spawnID0001/allpeople-wave-pcb/resources/placement-idea-pcb.png

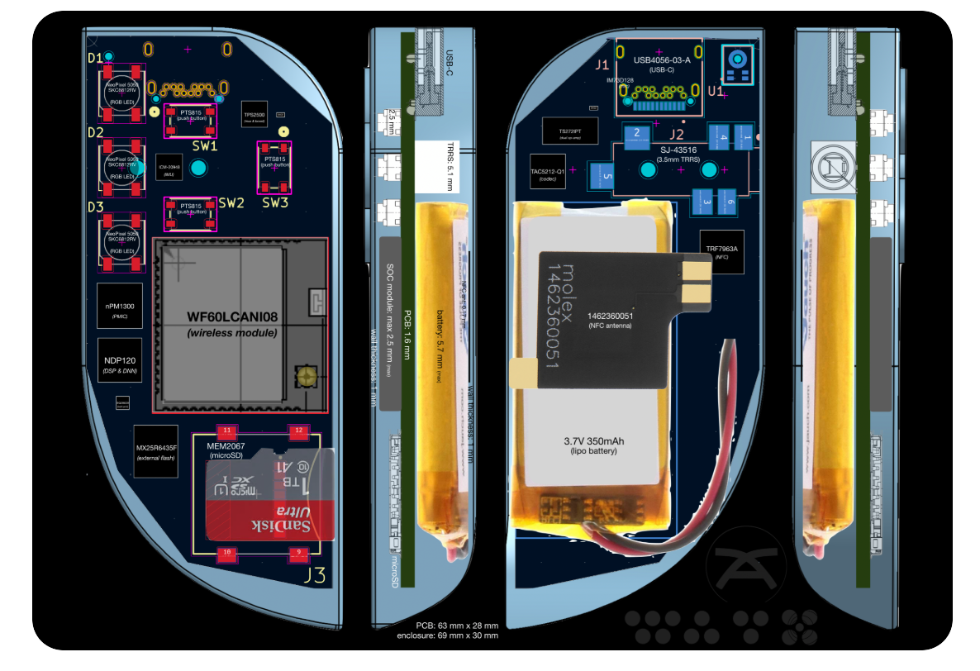
resources/placement-idea-pcb.png
