spawnID0001/allpeople-wave-pcb/resources/hardware-architecture.png

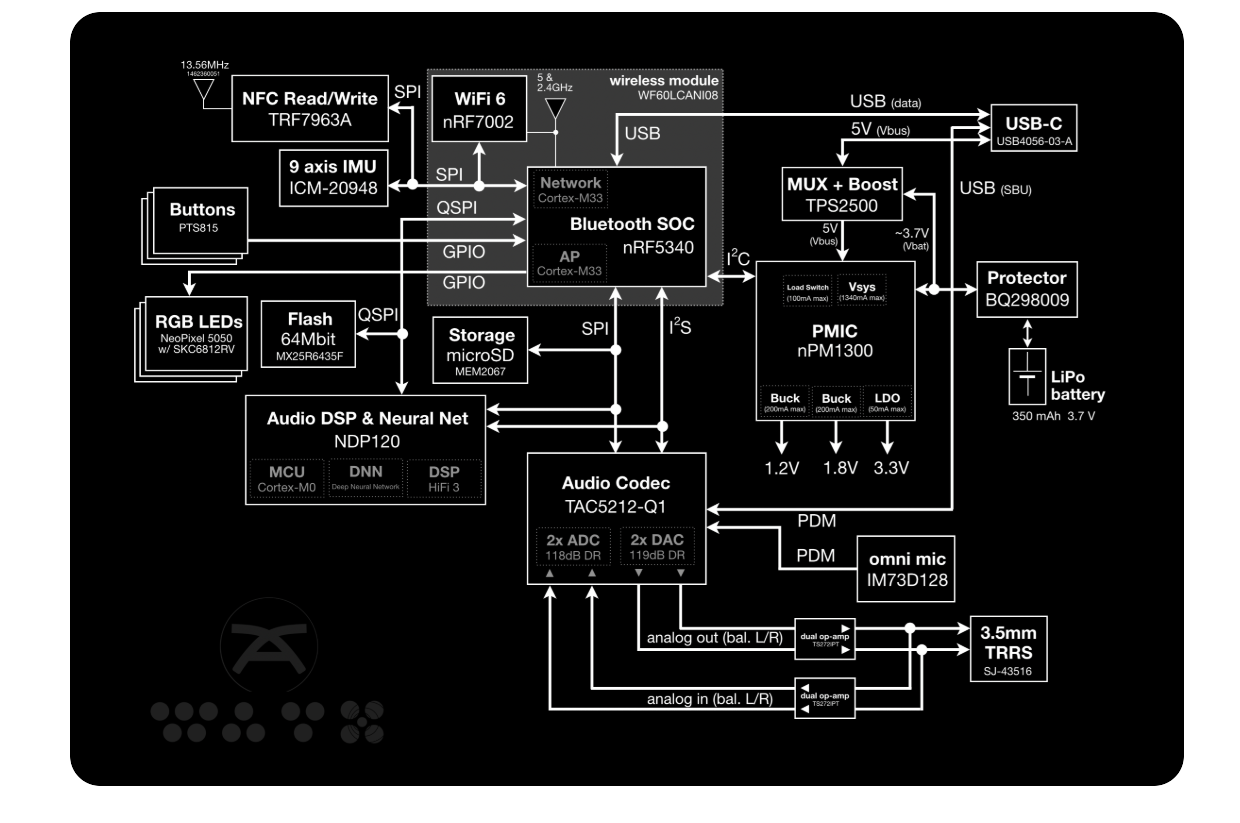
resources/hardware-architecture.png
