spawnID0001/allpeople-wave-pcb/pcb-files/Wave.kicad_pcb

## KiCad design pcb-files/Wave.kicad_pcb (2025-05-11)

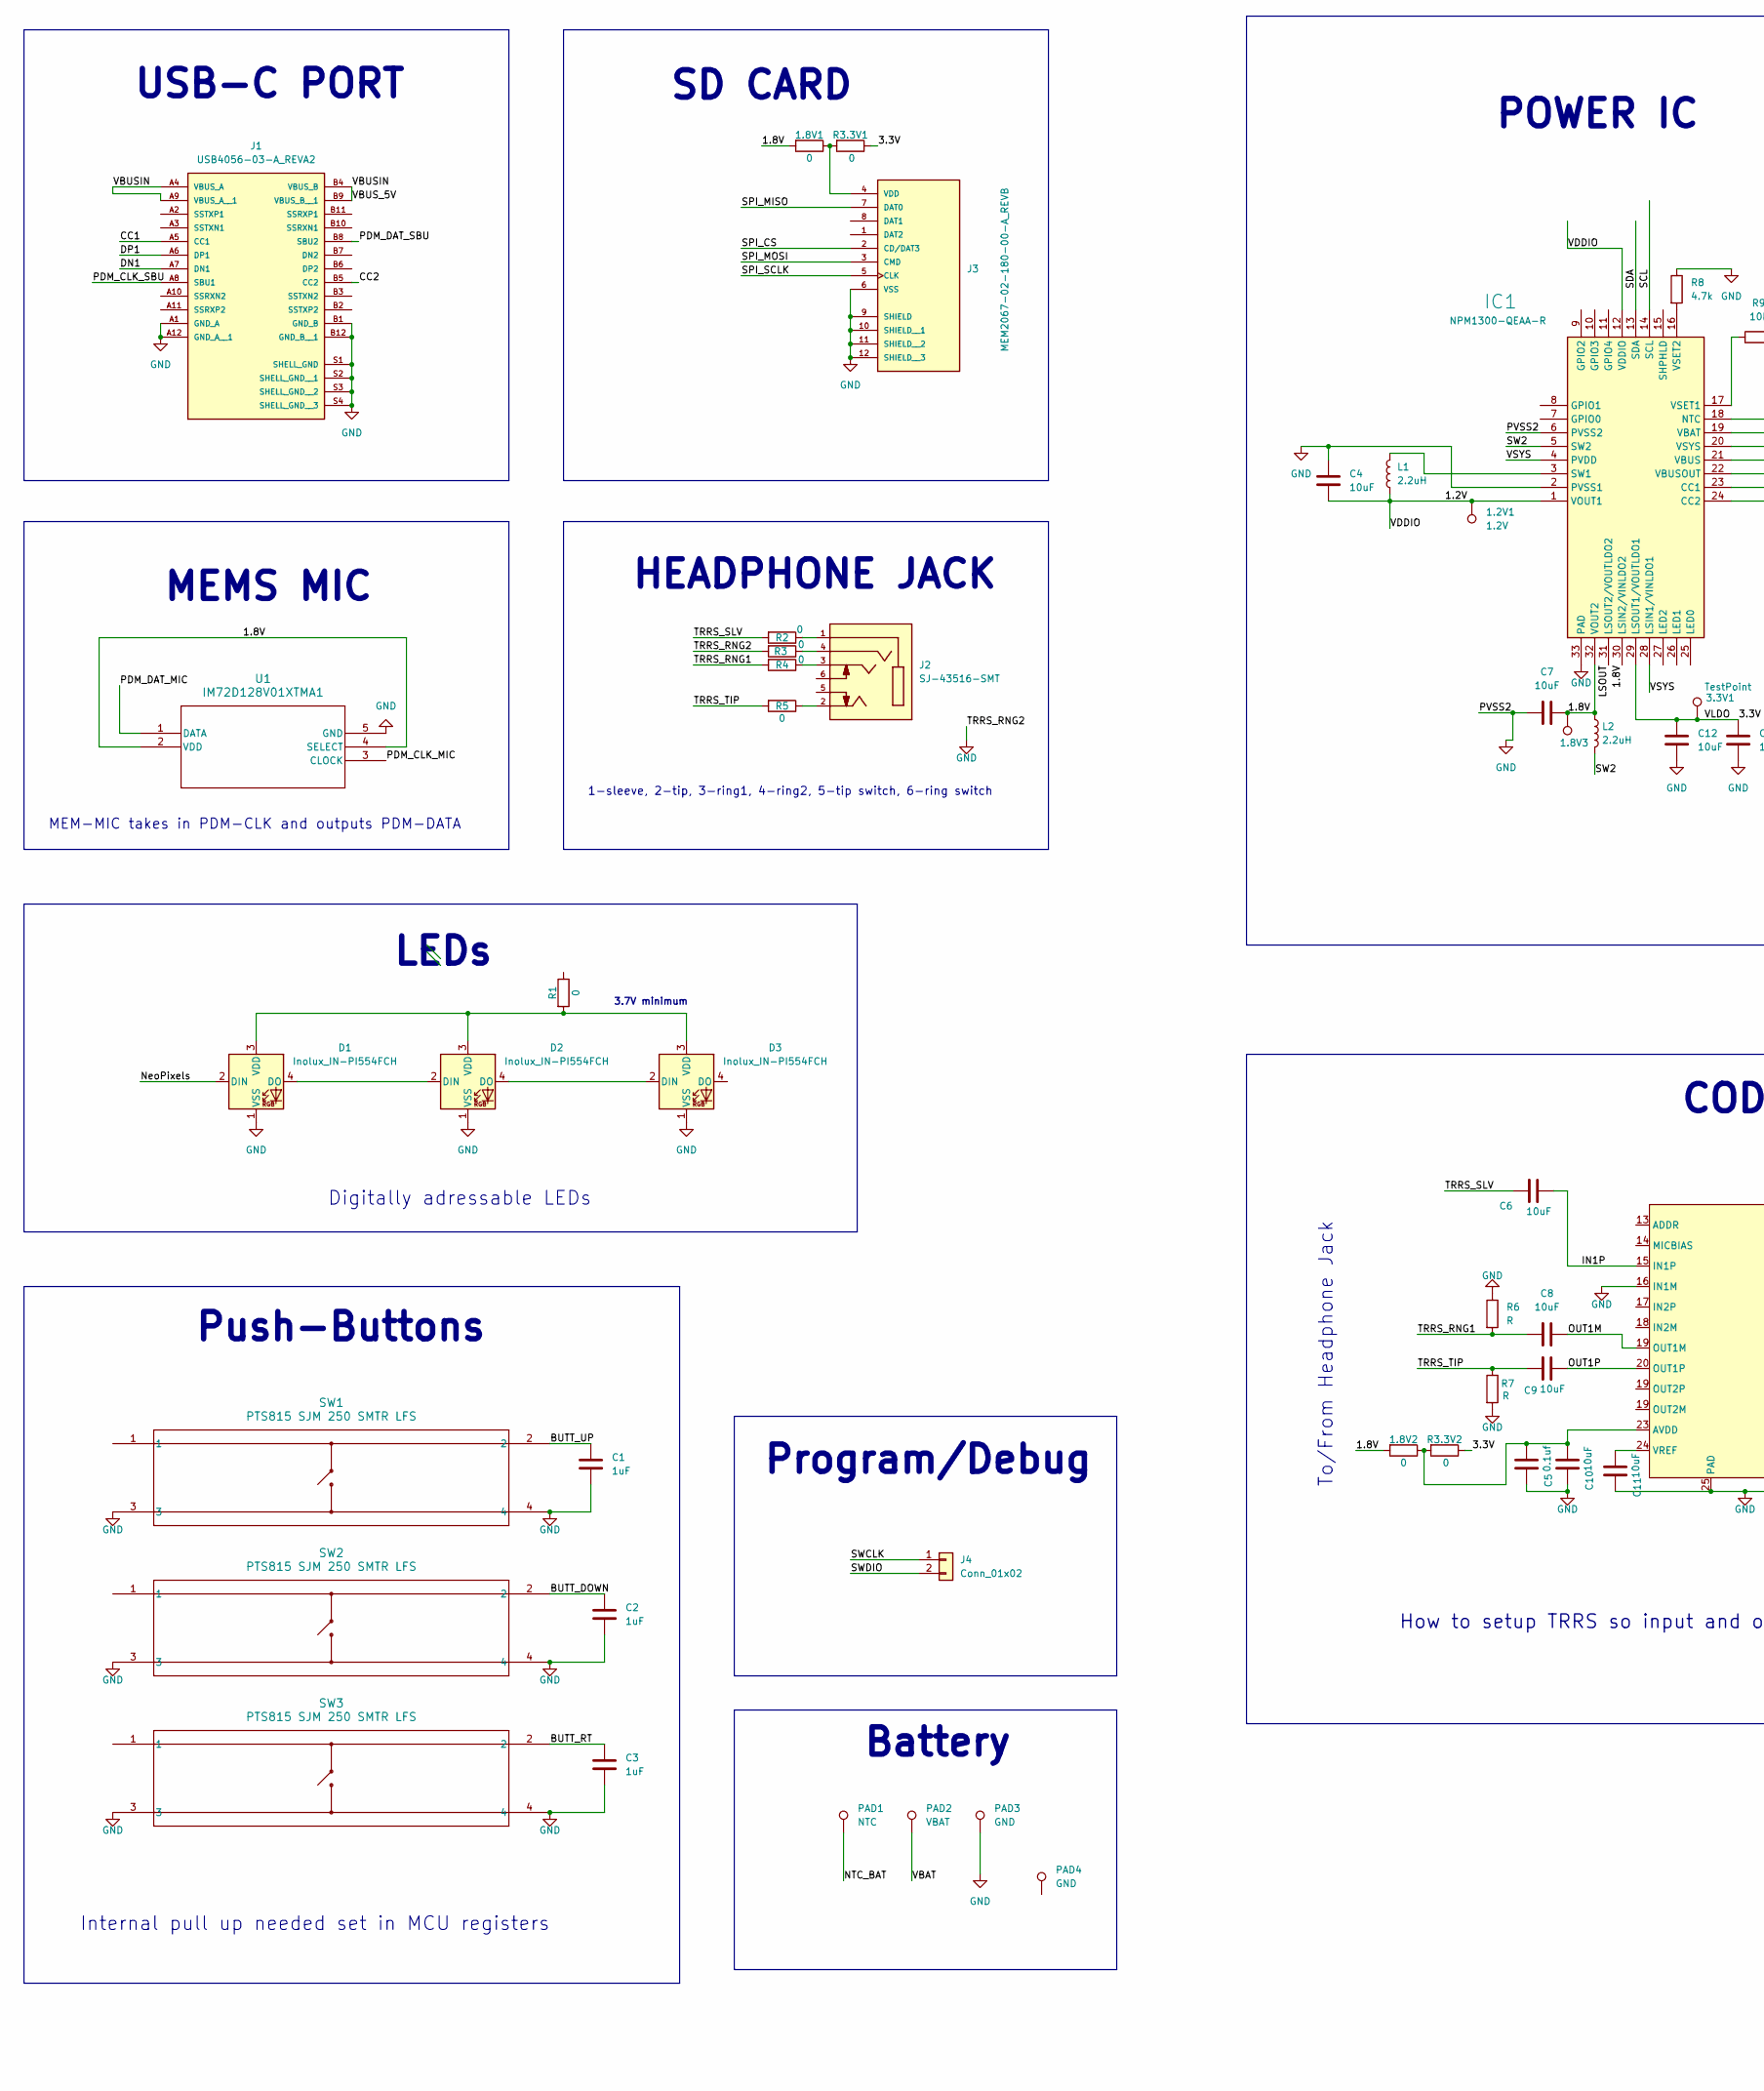
[picture p3: schematic Wave.kicad_sch, part in row 1, column 1]

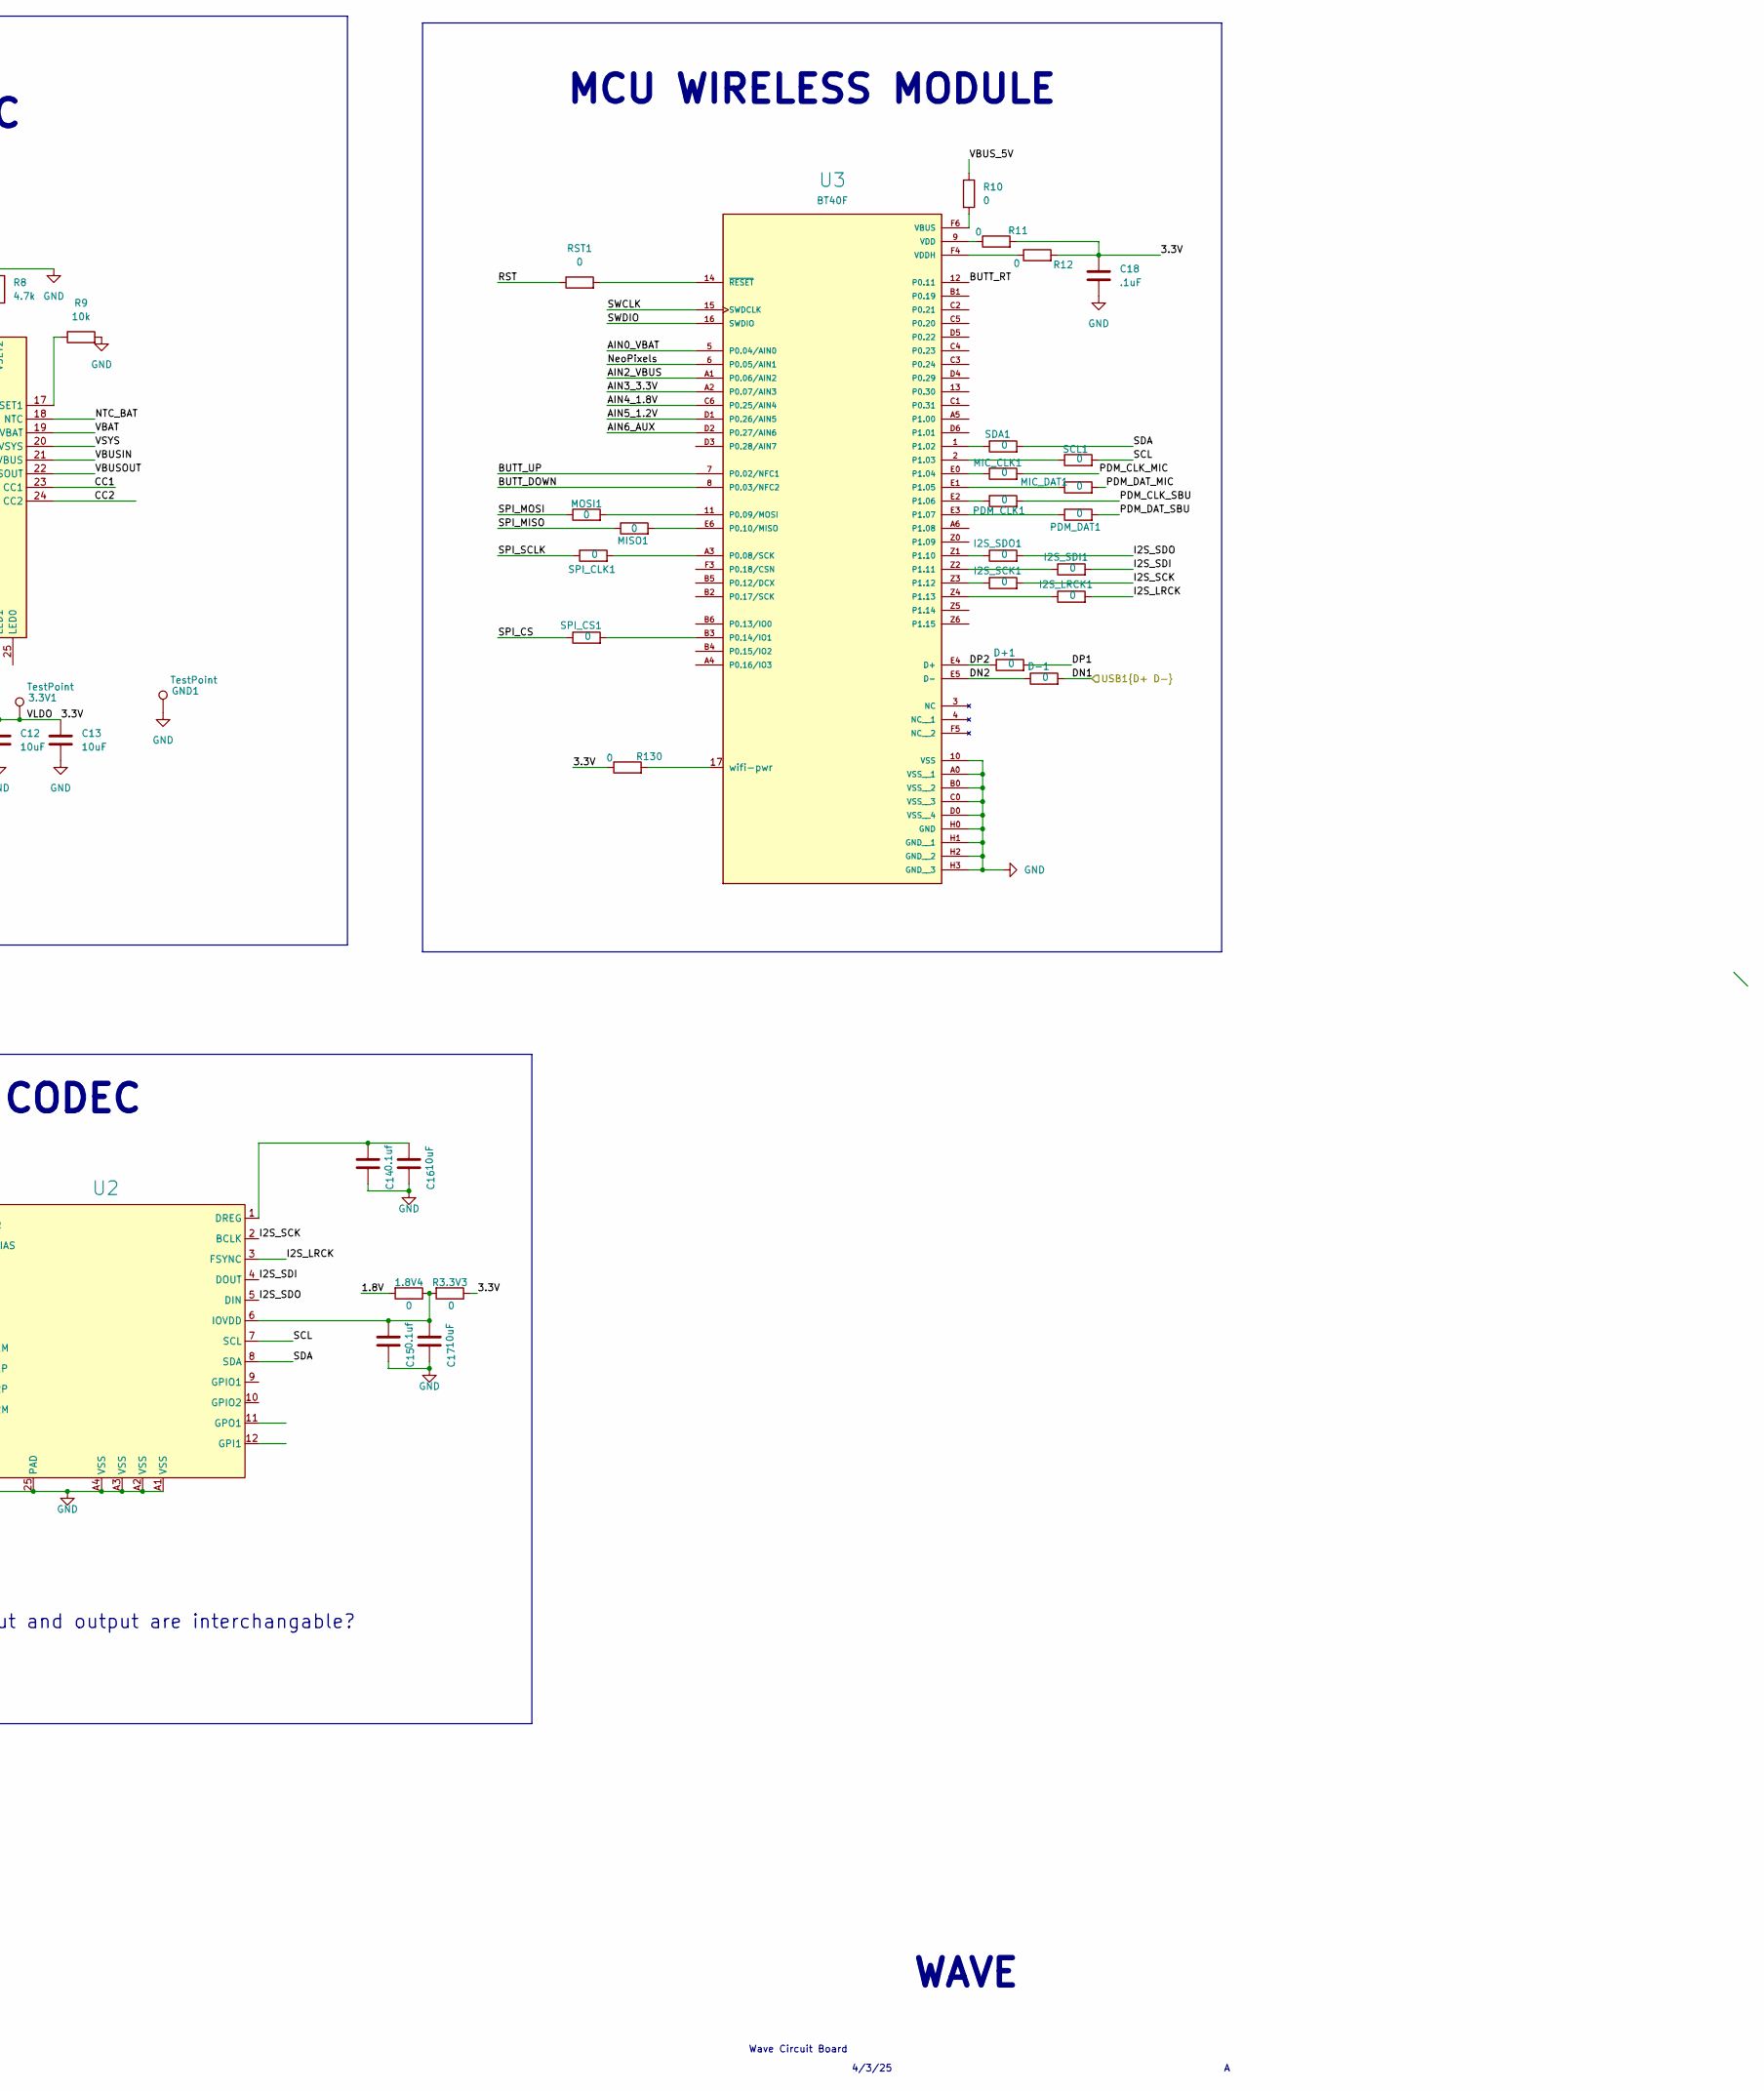
[picture p4: schematic Wave.kicad_sch, part in row 1, column 2]

Parts:
1.2V1: 1.2V; TestPoint_Pad_1.0x1.0mm
1.8V1, 1.8V2, 1.8V4: 0; R_0402_1005Metric
1.8V3: 1.8V; TestPoint_Pad_1.0x1.0mm
3.3V1: TestPoint; TestPoint_Pad_1.0x1.0mm
C1, C2, C3: 1uF; C_0402_1005Metric_Pad0.74x0.62mm_HandSolder
C4, C6, C7, C8, C9, C10, C11, C12, C13, C16, C17: 10uF; C_0402_1005Metric_Pad0.74x0.62mm_HandSolder
C5, C14, C15: 0.1uf; C_0402_1005Metric_Pad0.74x0.62mm_HandSolder
C18: .1uF; C_0402_1005Metric_Pad0.74x0.62mm_HandSolder
D1, D2, D3: Inolux_IN-PI554FCH; LED_Inolux_IN-PI554FCH_PLCC4_5.0x5.0mm_P3.2mm
D+1: 0; R_0402_1005Metric
D-1: 0; R_0402_1005Metric
GND1: TestPoint; TestPoint_Pad_1.0x1.0mm
I2S_LRCK1, I2S_SCK1, I2S_SDI1, I2S_SDO1: 0; R_0402_1005Metric
IC1: NPM1300-QEAA-R; QFN50P500X500X90-33N; Manufacturer_Part_Number NPM1300-QEAA-R
J1: USB4056-03-A_REVA2; GCT_USB4056-03-A_REVA2; PARTREV A2
J2: SJ-43516-SMT; CUI_SJ-43516-SMT; PART_REV 1.02; DigiKey_Part_Number CP-43516SJTR-ND
J3: MEM2067-02-180-00-A_REVB; GCT_MEM2067-02-180-00-A_REVB
J4: Conn_01x02; PinHeader_1x02_P1.00mm_Vertical; Part Number 1-0201FBV0T
L1, L2: 2.2uH; L_0402_1005Metric
MIC_CLK1: 0; R_0402_1005Metric
MIC_DAT1: 0; R_0402_1005Metric
MISO1: 0; R_0402_1005Metric
MOSI1: 0; R_0402_1005Metric
PAD1: NTC; TestPoint_Pad_D2.0mm
PAD2: VBAT; TestPoint_Pad_D2.0mm
PAD3: GND; TestPoint_Pad_D2.0mm
PAD4: GND; Battery_CR1225
PDM_CLK1: 0; R_0402_1005Metric
PDM_DAT1: 0; R_0402_1005Metric
R1, R2, R3, R3.3V1, R3.3V2, R3.3V3, R4, R5, R10, R11, R12, R130: 0; R_0402_1005Metric
R6, R7: R; R_0402_1005Metric
R8: 4.7k; R_0402_1005Metric
R9: 10k; R_0402_1005Metric
RST1: 0; R_0402_1005Metric
SCL1: 0; R_0402_1005Metric
SDA1: 0; R_0402_1005Metric
SPI_CLK1: 0; R_0402_1005Metric
SPI_CS1: 0; R_0402_1005Metric
SW1, SW2, SW3: PTS815 SJM 250 SMTR LFS; SW4_PTS815 SJM 250 SMTR LFS_CNK
U1: IM72D128V01XTMA1; PG-LLGA-5-3_INF
U2: WAVE_CODEC
U3: BT40F; XCVR_BT40F; PARTREV 1.01

Connections:
/1.2V: 1.2V1.1, C4.2, IC1.1 (VOUT1), IC1.12 (VDDIO), L1.1
/1.8V: 1.8V1.2, 1.8V2.2, 1.8V3.1, 1.8V4.2, C7.2, IC1.30 (LSIN2/VINLDO2), IC1.32 (VOUT2), L2.1, U1.2 (VDD), U1.4 (SELECT)
/3.3V: 3.3V1.1, C12.2, C13.2, C18.1, IC1.29 (LSOUT1/VOUTLDO1), R3.3V1.1, R3.3V2.1, R3.3V3.1, R11.2, R12.2, R130.1
/AIN0_VBAT: U3.5 (P0.04/AIN0)
/AIN2_VBUS: U3.A1 (P0.06/AIN2)
/AIN3_3.3V: U3.A2 (P0.07/AIN3)
/AIN4_1.8V: U3.C6 (P0.25/AIN4)
/AIN5_1.2V: U3.D1 (P0.26/AIN5)
/AIN6_AUX: U3.D2 (P0.27/AIN6)
/BUTT_DOWN: C2.1, SW2.2, U3.8 (P0.03/NFC2)
/BUTT_RT: C3.1, SW3.2, U3.12 (P0.11)
/BUTT_UP: C1.1, SW1.2, U3.7 (P0.02/NFC1)
/CC1: IC1.23 (CC1), J1.A5 (CC1)
/CC2: IC1.24 (CC2), J1.B5 (CC2)
/DN1: D-1.2, J1.A7 (DN1)
/DN2: D-1.1, U3.E5 (D-)
/DP1: D+1.2, J1.A6 (DP1)
/DP2: D+1.1, U3.E4 (D+)
/I2S_LRCK: I2S_LRCK1.2, U2.3 (FSYNC)
/I2S_SCK: I2S_SCK1.2, U2.2 (BCLK)
/I2S_SDI: I2S_SDI1.2, U2.4 (DOUT)
/I2S_SDO: I2S_SDO1.2, U2.5 (DIN)
/IN1P: C6.2, U2.15 (IN1P)
/LSOUT: IC1.31 (LSOUT2/VOUTLDO2)
/NTC_BAT: IC1.18 (NTC), PAD1.1; also elsewhere on the board
/NeoPixels: D1.2 (DIN), U3.6 (P0.05/AIN1)
/OUT1M: C8.2, U2.19 (OUT1M)
/OUT1P: C9.2, U2.20 (OUT1P)
/PDM_CLK_MIC: MIC_CLK1.2, U1.3 (CLOCK)
/PDM_CLK_SBU: J1.A8 (SBU1), PDM_CLK1.2
/PDM_DAT_MIC: MIC_DAT1.2, U1.1 (DATA)
/PDM_DAT_SBU: J1.B8 (SBU2), PDM_DAT1.2
/RST: RST1.1
/SCL: IC1.14 (SCL), SCL1.2, U2.7 (SCL)
/SDA: IC1.13 (SDA), SDA1.2, U2.8 (SDA)
/SPI_CS: J3.2 (CD/DAT3), SPI_CS1.1
/SPI_MISO: J3.7 (DAT0), MISO1.1
/SPI_MOSI: J3.3 (CMD), MOSI1.1
/SPI_SCLK: J3.5 (CLK), SPI_CLK1.1
/SW2: IC1.5 (SW2), L2.2
/SWCLK: J4.1, U3.15 (SWDCLK)
/SWDIO: J4.2, U3.16 (SWDIO)
/TRRS_RNG1: C8.1, R4.2, R6.2
/TRRS_SLV: C6.1, R2.2; also elsewhere on the board
/TRRS_TIP: C9.1, R5.2, R7.1
/VBAT: IC1.19 (VBAT), PAD2.1; also elsewhere on the board
/VBUSIN: IC1.21 (VBUS), J1.A4 (VBUS_A), J1.A9 (VBUS_A__1), J1.B4 (VBUS_B), J1.B9 (VBUS_B__1), R10.1
/VBUSOUT: IC1.22 (VBUSOUT)
/VSYS: IC1.4 (PVDD), IC1.20 (VSYS), IC1.28 (LSIN1/VINLDO1)
GND: C1.2, C2.2, C3.2, C4.1, C5.1, C7.1, C10.1, C11.1, C12.1, C13.1, C14.1, C15.1, C16.1, C17.1, C18.2, D1.1 (VSS), D2.1 (VSS), D3.1 (VSS), GND1.1, IC1.2 (PVSS1), IC1.6 (PVSS2), IC1.33 (PAD), J1.A1 (GND_A), J1.A12 (GND_A__1), J1.B1 (GND_B), J1.B12 (GND_B__1), J1.S1 (SHELL_GND), J1.S2 (SHELL_GND__1), J1.S3 (SHELL_GND__2), J1.S4 (SHELL_GND__3), J3.6 (VSS), J3.9 (SHIELD), J3.10 (SHIELD__1), J3.11 (SHIELD__2), J3.12 (SHIELD__3), PAD3.1, R3.2, R6.1, R7.2, R8.1, R9.2, SW1.3, SW1.4, SW2.3, SW2.4, SW3.3, SW3.4, U1.5 (GND), U2.16 (IN1M), U2.25 (PAD), U2.A1 (VSS), U2.A2 (VSS), U2.A3 (VSS), U2.A4 (VSS), U3.10 (VSS), U3.A0 (VSS__1), U3.B0 (VSS__2), U3.C0 (VSS__3), U3.D0 (VSS__4), U3.H0 (GND), U3.H1 (GND__1), U3.H2 (GND__2), U3.H3 (GND__3); also elsewhere on the board
unnamed: D1.4 (DO), D2.2 (DIN)
unnamed: D1.3 (VDD), D2.3 (VDD), D3.3 (VDD), R1.2
unnamed: D2.4 (DO), D3.2 (DIN)
unnamed: IC1.3 (SW1), L1.2
unnamed: IC1.17 (VSET1), R9.1
unnamed: IC1.16 (VSET2), R8.2
unnamed 56: J2.1, R2.1; also elsewhere on the board
unnamed: J2.2, R5.1
unnamed: J2.3, R4.1
unnamed: J2.4, R3.1
unnamed: 1.8V1.1, J3.4 (VDD), R3.3V1.2
unnamed: 1.8V2.1, C5.2, C10.2, R3.3V2.2, U2.23 (AVDD)
unnamed: C14.2, C16.2, U2.1 (DREG)
unnamed: 1.8V4.1, C15.2, C17.2, R3.3V3.2, U2.6 (IOVDD)
unnamed: C11.2, U2.24 (VREF)
unnamed: SPI_CLK1.2, U3.A3 (P0.08/SCK)
unnamed: MOSI1.2, U3.11 (P0.09/MOSI)
unnamed: MISO1.2, U3.E6 (P0.10/MISO)
unnamed: SPI_CS1.2, U3.B3 (P0.14/IO1)
unnamed: SDA1.1, U3.1 (P1.02)
unnamed: SCL1.1, U3.2 (P1.03)
unnamed: MIC_CLK1.1, U3.E0 (P1.04)
unnamed: MIC_DAT1.1, U3.E1 (P1.05)
unnamed: PDM_CLK1.1, U3.E2 (P1.06)
unnamed: PDM_DAT1.1, U3.E3 (P1.07)
unnamed: I2S_SDO1.1, U3.Z1 (P1.10)
unnamed: I2S_SDI1.1, U3.Z2 (P1.11)
unnamed: I2S_SCK1.1, U3.Z3 (P1.12)
unnamed: I2S_LRCK1.1, U3.Z4 (P1.13)
unnamed: R10.2, U3.F6 (VBUS)
unnamed: R11.1, U3.9 (VDD)
unnamed: R12.1, U3.F4 (VDDH)
unnamed: R130.2, U3.17 (wifi-pwr)
unnamed: RST1.2, U3.14 (~RESET)

Notes on the sheet:
4/3/25
Wave Circuit Board
MEM-MIC takes in PDM-CLK and outputs PDM-DATA
How to setup TRRS so input and output are interchangable?
SD CARD
Push-Buttons
Battery
3.7V minimum
USB-C PORT
Internal pull up needed set in MCU registers
To/From Headphone Jack
POWER IC
Digitally adressable LEDs
1-sleeve, 2-tip, 3-ring1, 4-ring2, 5-tip switch, 6-ring switch
HEADPHONE JACK
MCU WIRELESS MODULE
MEMS MIC
Program/Debug
WAVE
LEDs
CODEC

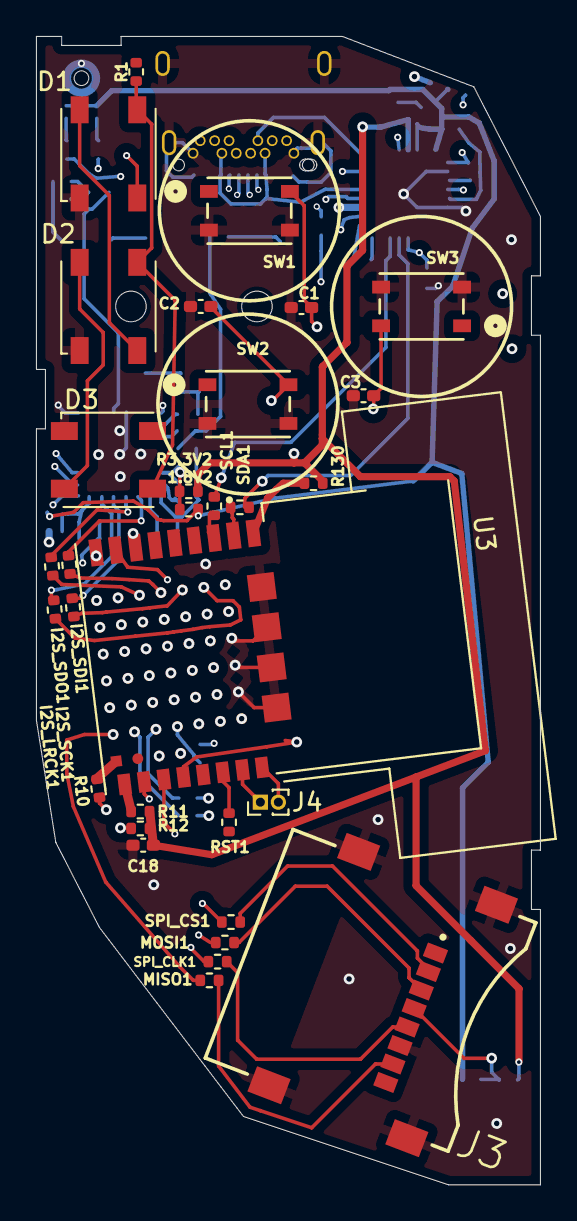
[picture p5: board Wave.kicad_pcb from above]

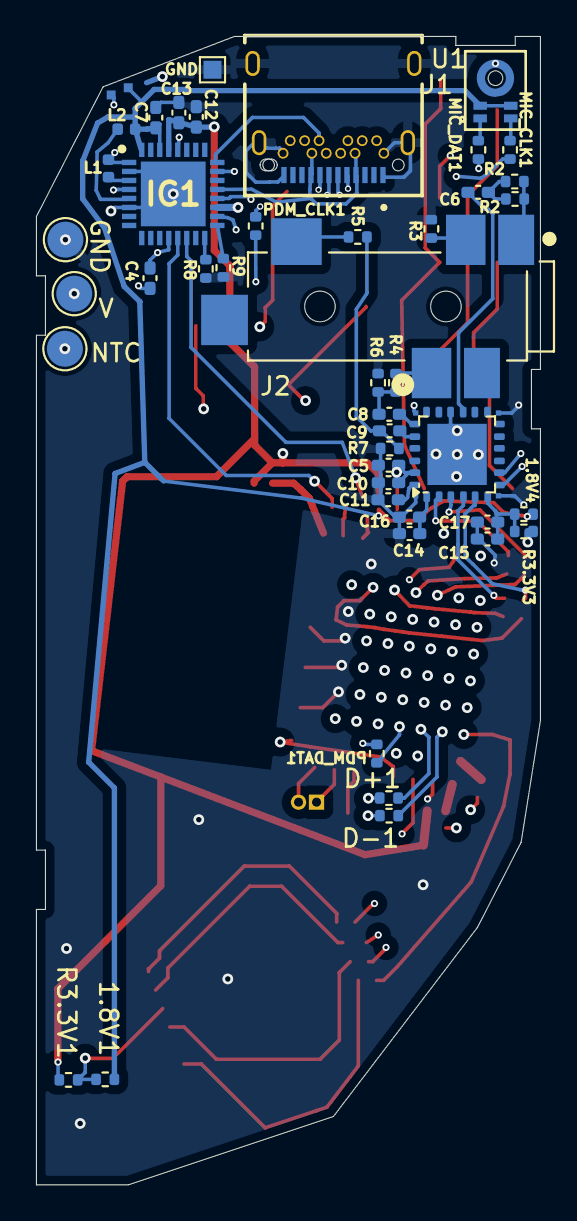
[picture p6: board Wave.kicad_pcb from below]

Board: 4 copper layers, 28.0 x 63.8 mm, 78 parts (47 on the bottom side), 75 nets.

Other parts of the board:
GND: GND; TestPoint_Pad_D2.0mm
GND#2: TestPoint; TestPoint_Pad_1.0x1.0mm
NTC: NTC; TestPoint_Pad_D2.0mm
R2#2: 0; R_0402_1005Metric
V: VBAT; TestPoint_Pad_D2.0mm

Their connections:
/NTC_BAT: NTC.1; also elsewhere on the board
/TRRS_SLV: R2#2.2; also elsewhere on the board
/VBAT: V.1; also elsewhere on the board
GND: GND.1, GND#2.1; also elsewhere on the board
unnamed 56: R2#2.1; also elsewhere on the board
