spawnID0001/allpeople-wave-pcb/(commit log)

2025-03-12 New Sch Doc with pin 17 for wifi module
    [Wave.kicad_sch]
2025-04-07 Layout V1
    First Layout of Wave v1
    [Wave.kicad_pcb, Wave.kicad_sch]
2025-05-11 Silkscreen update
    Updated Silkscreen
    [Wave.kicad_pcb]
